nikolajbaer/mini-esp32-rover/cad/stl/chassis.stl

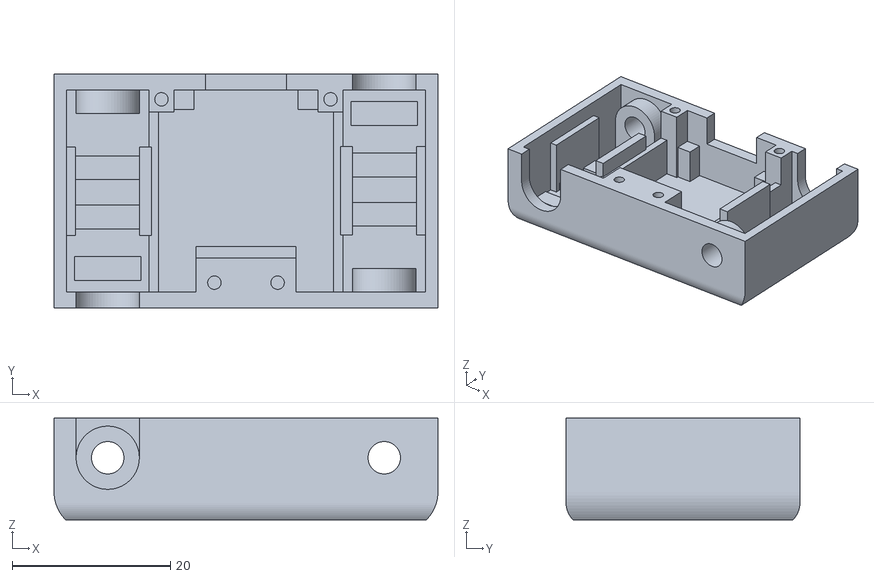
[picture p3: CAD file, 2026-11-14]
cad/stl/chassis.stl
48.6 x 29.6 x 12.9
