nikolajbaer/mini-esp32-rover/cad/stl/deck.stl

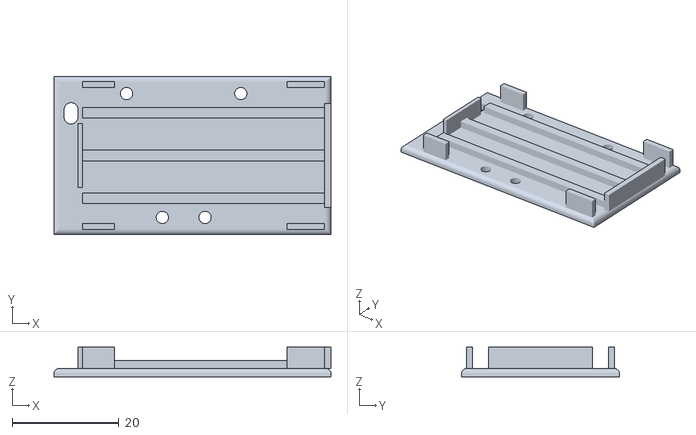
[picture p4: CAD file, 2026-11-14]
cad/stl/deck.stl
51.9 x 29.6 x 5.59
