nikolajbaer/mini-esp32-rover/cad/stl/track.stl

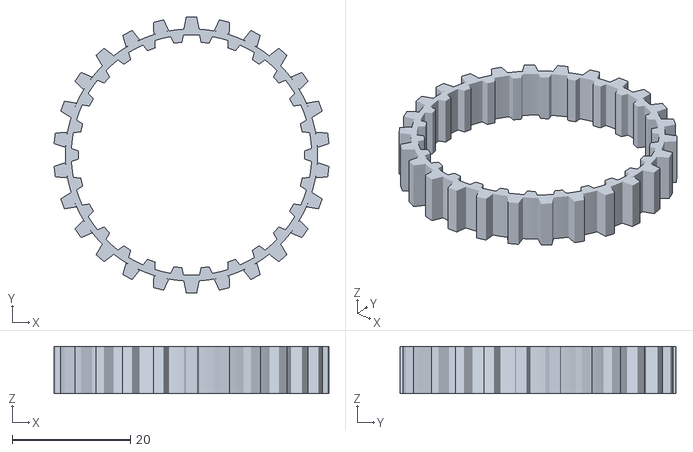
[picture p5: CAD file, 2026-11-12]
cad/stl/track.stl
46.6 x 46.7 x 8.00
