nikolajbaer/mini-esp32-rover/cad/stl/hubtest.stl

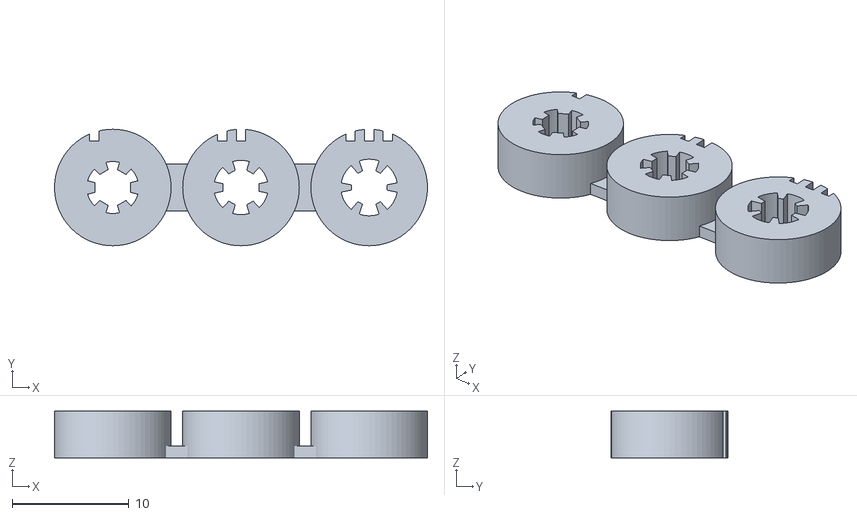
[picture p6: CAD file, 2026-11-12]
cad/stl/hubtest.stl
32.0 x 10.0 x 4.00
