nikolajbaer/mini-esp32-rover/cad/stl/idler.stl

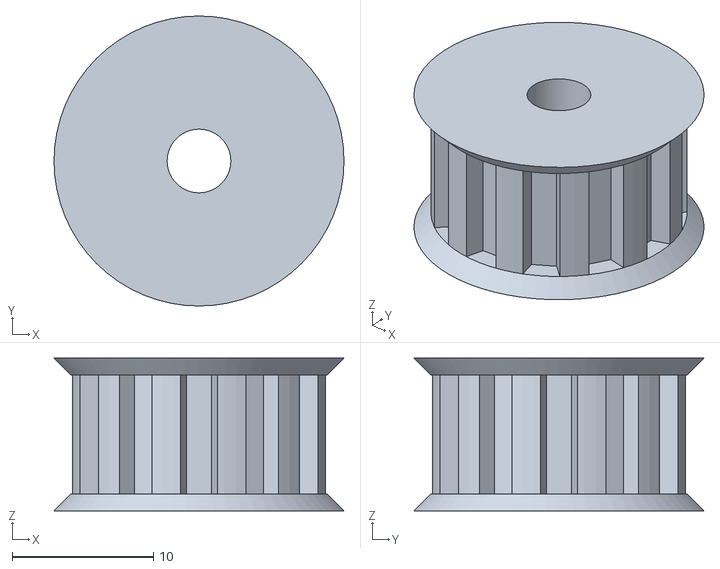
[picture p7: CAD file, 2026-11-12]
cad/stl/idler.stl
20.5 x 20.5 x 10.8
