nikolajbaer/mini-esp32-rover/cad/stl/sprocket.stl

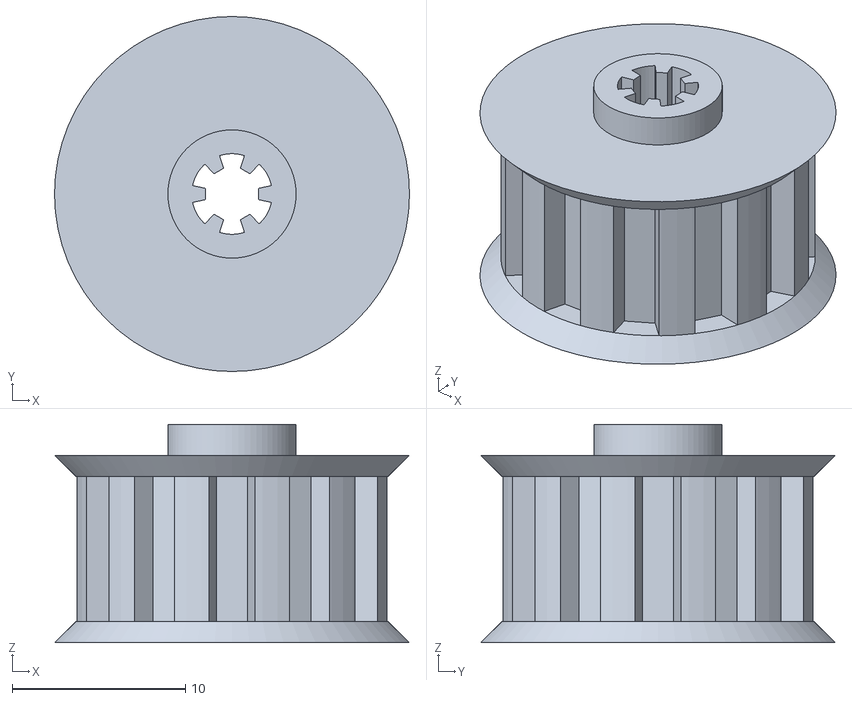
[picture p8: CAD file, 2026-11-12]
cad/stl/sprocket.stl
20.5 x 20.5 x 12.6
