nikolajbaer/mini-esp32-rover/cad/stl/pin.stl

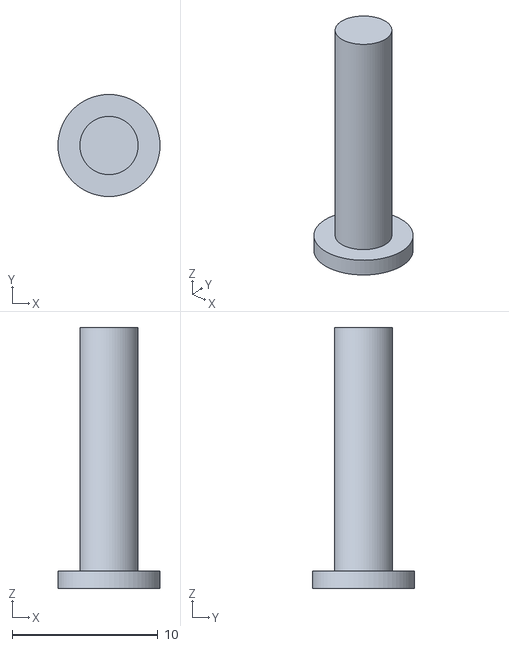
[picture p9: CAD file, 2026-11-12]
cad/stl/pin.stl
7.00 x 7.00 x 17.9
