nikolajbaer/mini-esp32-rover/(commit log)

2026-11-10 Add first-pass mini tracked rover: parametric CAD, firmware, docs
    - cad/rover.scad: parametric OpenSCAD model (chassis tub, deck, drive
    sprockets, idlers, pins, TPU track) with exported STLs
    - firmware/: PlatformIO project for XIAO ESP32 + DRV8833; Wi-Fi AP with a
    WebSocket joystick page, ramped slow-decay PWM and a command failsafe
    - README with wiring, printing and assembly notes
    Claude-Session: https://claude.ai/code/session_01SS3pM45xADCfPm34WKqHex
    [chassis.stl, deck.stl, idler.stl, pin.stl, rover.scad, sprocket.stl, track.stl]
2026-11-10 Fit sprocket hub to the gearbox output pinion
    The motors end in a small pinion gear rather than a D shaft. Add a
    parametric star socket (tooth count, tip and root diameter, clearance),
    keep the D bore as an option, and add a three-clearance fit-test piece.
    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
    [hubtest.stl, rover.scad, sprocket.stl]
2026-11-10 Size hub socket from measured pinion: 6 teeth, 4.46 mm OD, 0.75 mm valleys
    Replace the guessed star socket with a round bore at the tip diameter
    plus one key per valley, sized from the valley width so the root
    diameter is not needed.
    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
    [hubtest.stl, rover.scad, sprocket.stl]
2026-11-10 Fix hubtest: joining web blocked the bottom of bores 2 and 3
    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
    [hubtest.stl, rover.scad]
2026-11-11 Fit motor pocket to measured motor: 10 mm round can with 8 mm flats
    Gearbox is 10 x 7 mm and the can is the same diameter, so the old
    shoulder against the wall no longer exists. The can now drops between
    two cheeks that grip its flats (anti-rotation); the wider gearbox butts
    against the cheek ends. Sprocket recess and body length follow.
    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
    [chassis.stl, deck.stl, hubtest.stl, idler.stl, pin.stl, rover.scad, sprocket.stl]
2026-11-11 Record measured pinion length (3 mm + 0.5 mm tip)
    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
    [rover.scad]
2026-11-11 Size DRV8833 pocket to measured board (18.6 x 16 mm)
    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
    [deck.stl, rover.scad]
2026-11-12 Add wiring diagram
    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
2026-11-12 Capture motors positively, print track as a round ring, taller treads
    From the first test print:
    - Motors had nothing holding them. The gearbox now sits inside the tub,
    trapped between the wall (slot passes only the pinion) and the cheek
    ends; cheeks grip the can flats with a tighter fit. The sprocket gets a
    nose that reaches through the wall to the gearbox face.
    - Track was tight and ran lopsided. It is now a round ring, 2 mm longer
    than the first print (track_slack), with 2 mm treads.
    - Ground clearance now follows the track thickness (3 -> 4.2 mm).
    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
    [chassis.stl, deck.stl, hubtest.stl, idler.stl, pin.stl, rover.scad, sprocket.stl, track.stl]
2026-11-12 Shrink the body: 5 mm shorter, 3.4 mm narrower
    - Battery bay cut to fit a 34 mm cell (belt 34 -> 32 teeth, wheelbase 50)
    - Tub narrowed to 24.6 mm inside; deck screw posts become shallow ribs
    with the pilot hole set partly into the wall
    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
    [chassis.stl, deck.stl, hubtest.stl, idler.stl, pin.stl, rover.scad, sprocket.stl, track.stl]
2026-11-12 Stacked layout: driver and XIAO between the motors, battery on the deck
    Chassis shrinks from 63.6 to 48.6 mm long (rover 74 -> 59 mm) with the
    same wheels. The DRV8833 lies on the tub floor, the XIAO sits on shelves
    above it with its USB-C socket in a notch in the left wall, reachable
    between the track runs, and the 33 x 20 x 6.25 mm battery sits between
    rails on top of a flat-bottomed deck.
    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
    [chassis.stl, deck.stl, hubtest.stl, idler.stl, rover.scad, sprocket.stl, track.stl]
2026-11-12 Widen the track tread to cover the wheels
    The band's edges now flare out at 45 degrees over the wheel flanges and
    the tread bars run the full wheel width. The flare matches the flange
    cone and keeps the ring printable on its edge without supports; it is
    slit between bars so it adds no hoop stiffness.
    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
    [rover.scad, track.stl]
2026-11-12 Revert to the plain track with taller treads
    The wheel-width flared tread looked unlikely to print well in TPU.
    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
    [rover.scad, track.stl]
2026-11-14 Bigger battery, snap-on cover, rounded corners
    - Deck grows to 59.9 mm (overhanging the tub between the tracks) to carry
    a 45 x 25 x 10 mm cell on ribs, with a compartment behind it for the
    battery plug and a lead hole down beside the rear motor
    - New cover clicks over two snap tabs on the deck
    - Tub gets rounded corners and a chamfered bottom edge, and is 1 mm
    wider inside to make room for the battery leads
    - Deck screw holes move inward so the heads clear the cover walls
    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
    [chassis.stl, cover.stl, deck.stl, rover.scad]
2026-11-14 Drop the battery cover; battery sits open with its plug above the deck
    The deck shrinks back to 51.9 mm: no plug compartment or snap tabs. The
    battery is pushed forward between corner rails so the lead hole behind it
    stays clear.
    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
    [cover.stl, deck.stl, rover.scad]
2026-11-14 Round the horizontal edges instead of the plan corners
    The tub is square in plan again, with its lower front/rear edges rounded
    at 5 mm and lower side edges at 3 mm; the arcs stop at 45 degrees so they
    print straight off the bed. The deck's top edge is rounded at 1 mm.
    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
    [chassis.stl, deck.stl, rover.scad]
